Nawrasrq/Rocket-Telemetry-Collection/Diagrams/Power Distribution.png

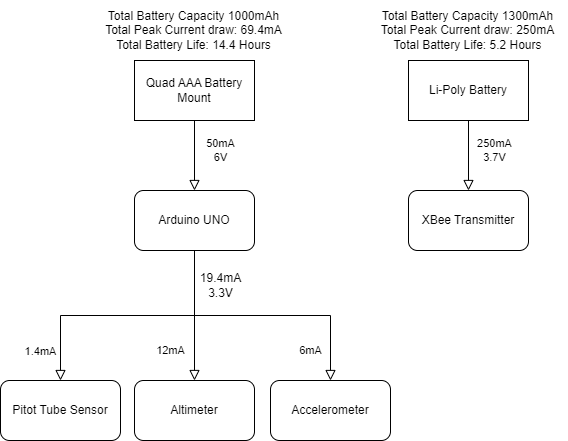
Diagrams/Power Distribution.png
