Nawrasrq/Rocket-Telemetry-Collection/Diagrams/Reciever Flowchart.png

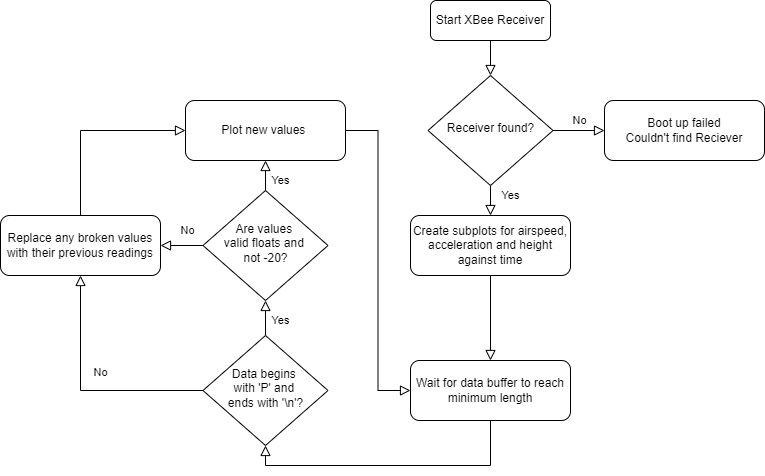
Diagrams/Reciever Flowchart.png
