Nawrasrq/Rocket-Telemetry-Collection/Diagrams/Transmitter Flowchart.png

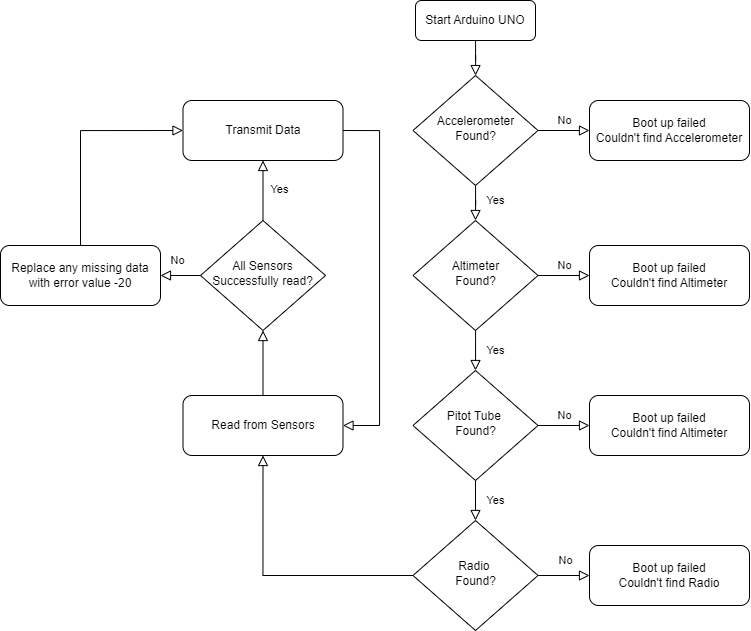
Diagrams/Transmitter Flowchart.png
