Nawrasrq/Rocket-Telemetry-Collection/(commit log)

2019-06-03 Create RocketSensorRead.ino
    Arduino File
2024-05-29 Update README.md
    Fix mislabeled sensor
2024-05-29 Bug fixes
    - Moved Xbee off of SoftwareSerial
    - Fixed pitot tube
    [Rocket_Telemetry_Receiver.py, Rocket_Telemetry_Transmitter.ino]
2024-05-30 Updated circuit sheet
2024-05-30 Moved old circuit sheet
2024-05-30 Bug fixes
    - More accurate values used instead of random values
    - Better error catch in Rocket_Telemetry_Receiver.py
    [Rocket_Telemetry_Receiver.py, Rocket_Telemetry_Sensor_Sim.ino]
